brianssparetime/darkroom_roller/img/IMG_3004_l.jpeg

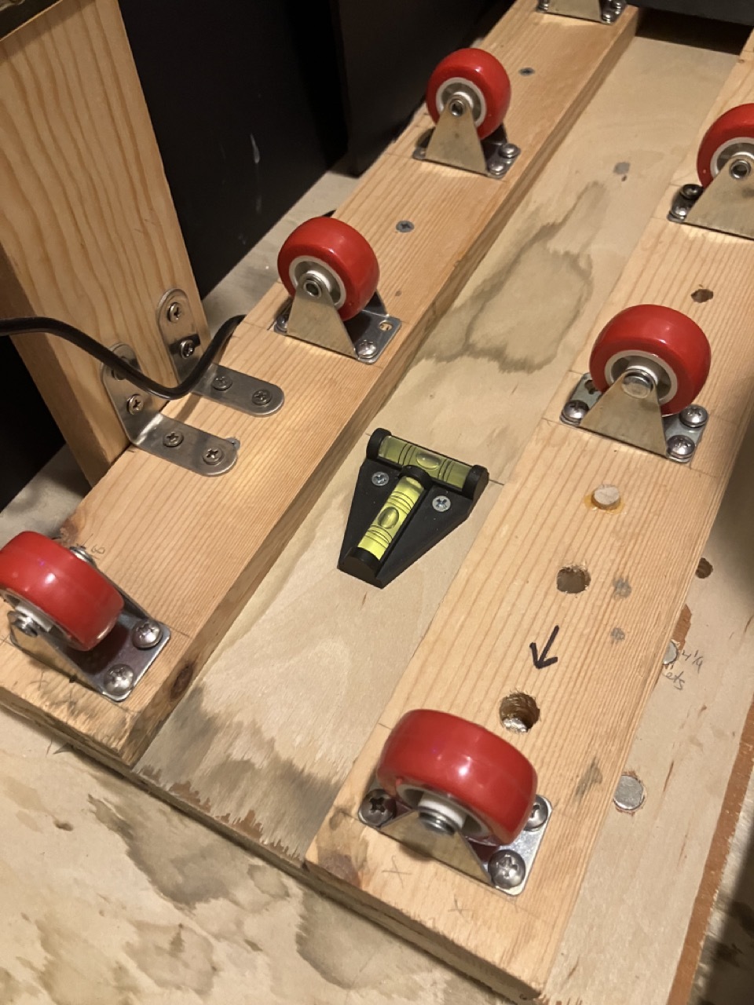
img/IMG_3004_l.jpeg
