brianssparetime/darkroom_roller/img/IMG_9809_l.jpeg

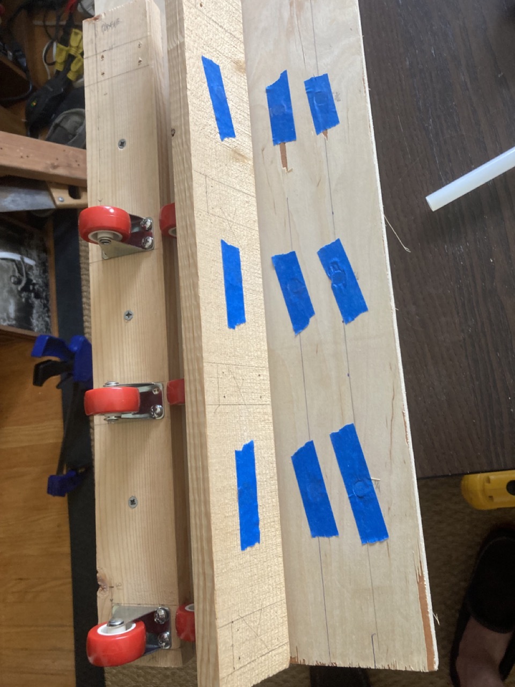
img/IMG_9809_l.jpeg
