brianssparetime/darkroom_roller/darkroom_roller/TimeGlue.h

#pragma once
#include "Arduino.h"

// purely static

class TimeGlue {
    public:
        static void TimeGlue::displayInterval(uint16_t seconds);
        static void TimeGlue::displayMSS(uint8_t mss[]);
        static uint16_t TimeGlue::MSStoInterval(uint8_t mss[]);
        static void zeroes();

    private:

};
