brianssparetime/darkroom_roller/darkroom_roller/REWrapper.h

#pragma once
#include "Encoder.h"
#include "Machine.h"

// TODO:  I should either make this a singleton like Machine, or make everything static like LCD_Wrapper/RHTimer...

class REWrapper {
    public:
        REWrapper(Encoder* enc);
        void update();

    private:

        void button_press();
        void button_long_press();
        void button_long_release();
        void rotation(int delta);
        
        unsigned long _last_action;
        const uint16_t push_cooldown = 200; //ms
        bool _long_press;
        bool _long_press_sent;
        const uint16_t rot_delay = 500; // ms
        const uint16_t _long_press_delay = 500; //ms
        Encoder* _encoder;
        bool disabled = false;

        // uint8_t is 0-255
        // unsigned int is 0-65535

};
