brianssparetime/darkroom_roller/(commit log)

2023-08-15 Moved buzzer times into buzzer.h; added sequence and indefinite/continuous buzz into buzzer.cpp
    [PinsGlobals.h, buzzer.cpp, buzzer.h]
2023-08-15 add flashing leds; fix bug in update for seq (no base case)
    [Leds.cpp, Leds.h, UI_States.cpp, buzzer.cpp]
2023-08-15 simplify hall
2023-08-15 add one to display time; add hall update
2023-09-06 cleaned up PinsGlobals; fixed bug in UI_States preventing UI_Active; added TODO in Timer; versioned hardware files
    [PinsGlobals.h, RHTimer.cpp, UI_States.cpp]
2023-09-06 all kinds of bug fixes
    [Leds.cpp, Stepper.cpp, Stepper.h, buzzer.cpp]
2023-09-06 equals equals bug solved
    [RHTimer.cpp]
2023-09-06 updated ST-STEP pin, some changes to stepper to make it cleaner and hopefully work
2023-09-06 fixing bugs I introduced recently
    [UI_States.cpp]
2023-09-06 added debug on timer update and millis overflow; increased max stepper speed
2023-09-06 remove timer update debug; remove redundant initialization in ui_interval_set; allow get_mult and inactive_timeout to be 16bit;
2023-09-07 added Leds::init to main setup(); removed erroneous timer start; remove zeroes call from timer; better CI debug; explicit update() for UI interval set
2023-09-07 reverse left/right on RE
    [UI_States.cpp]
2023-09-07 eliminate useless variable; adjust buzz times
    [UI_States.cpp, buzzer.h]
2023-09-07 added buzz on rotation to check for over-eager hall
    [Hall.cpp, Stepper.cpp]
2023-09-07 adding additional debug; reformat ino; add stepper tester
2023-09-07 fixes to test stepper
    [test_stepper.ino]
2023-09-07 fixed big bug with Active Update causing display update after alarm completes.
    [UI_States.cpp]
2024-01-24 Generally working (after tuning stepper driver vref to just over 1). Hall effect sensor is being triggered, but code is not seeing that.
2024-02-07 reworked display to keep digits and support blink; added TimeGlue for converting intervals to int[3], dropped Leds. Not yet tested.
    [Display.cpp, Display.h, Leds.cpp, Leds.h, RHTimer.cpp, Stepper.cpp, TimeGlue.cpp, TimeGlue.h]
2024-02-07 changed _edit_values back to unsigned, modified stepper to count its own rotations for now, finished removing Leds
2024-02-07 removed hall and replaced with Tilt; reworked stepper to count steps across entire reversal cycle instead of by rotations
    [Hall.cpp, Hall.h, Stepper.cpp, Stepper.h, Tilt.cpp, Tilt.h, UI_States.cpp, darkroom_roller.ino]
2024-02-09 moved zeroes(), fixed bug where zeroes didn't work; changed UI_I_Set to use edit_values
    [Display.cpp, Display.h, TimeGlue.cpp, TimeGlue.h, UI_States.cpp]
2024-02-09 fixed for loops from 4 to 3
    [Display.cpp, TimeGlue.cpp, UI_States.cpp]
2024-02-09 fixed = / ==
    [Display.cpp, Display.h, UI_States.cpp]
2024-02-09 reinstate blink and fixes to how _edit_values work; display now mostly functional
    [UI_States.cpp]
2024-02-09 time entry is working; but blinking gets too fast after a few seconds, and initial zero isnt' being suppressed always
    [darkroom_roller.ino]
2024-02-09 fixes for stuck blink, wrong overflow; still need zero time protection
    [Display.cpp, Display.h, UI_States.cpp]
2024-02-09 Added back in the tilt sensor
2024-02-10 added debug msg for error with erratic rervsing
    [Stepper.cpp, Stepper.h, UI_States.cpp]
2024-02-12 turn off debug, fix debug statements
    [Display.cpp]
2024-02-12 debugging on stepper reversing
    [Stepper.cpp, Stepper.h, TimeGlue.cpp]
2024-02-12 Stepper reverse testing
2024-02-12 sort of working but currentPosition isn't working quite right leading to irregular reverses
    [Stepper.cpp]
2024-02-12 changed to acceleration for stepper
2024-02-12 remove extra display code during active, when timer is handling it
2024-02-12 pausing, but not reversing, but doing it mutliple times
    [Stepper.cpp]
2024-02-12 doesn't reverse, but does pause once. need to make state change wait for sleeping and proper decel.
    [Stepper.cpp]
2024-02-13 changing constructor for stepper made things worse
2024-02-13 reverse code was being called twice per cycle; trying isrunning instead of dtg < 1
    [Stepper.cpp]
2024-06-04 fix to make starting time set by UI_States match default time specified in PinsGlobals.h
    [UI_States.cpp]
2024-06-06 increase rotations per cycle; add code for microstepping; random seeding; comment out old LED code
2025-08-06 changes for microstepping-capable pcb
2026-09-09 Document caster spacing math, refresh images
    - Fill in the two caster spacings (5 1/4" and 6 1/2", center to center)
    - Correct the sign in the spacing formula and define k against the caster
    mounting plane
    - Give caster spacing its own section with the clearance rationale
    - Add and rename photos, drop the unused video, strip EXIF from all images
    - Ignore img/temp working files
2026-09-09 Add the demo video to the repo
    The README plays it through a GitHub attachment URL, which lives on GitHub's
    asset host rather than in the tree. This keeps a copy alongside the source:
    H.264 720p, 27 seconds, 1.8 MB, metadata stripped.
